MechFriesen/IG_Handle_hardware/README.md

# IG_Handle_hardware
Hardware parts list and assembly instructions
