MechFriesen/IG_Handle_hardware/Parts-list.xlsx

Sheet: Digikey
 | The HTSUS and ECCN information shown is for informational purposes only and is not a representation or warranty as to the accuracy or reliability of these classifications. All information is provided "as is" and is subject to change without notice. Any use made of the information provided is without recourse to Digi-Key and at the user's risk.
 | Index | Manufacturer Part Number | Manufacturer Name | Description | Requested Quantity 1 | Pack Quantity 1 | Pack Type 1 | Digi-Key Part Number 1 | Unit Price 1 | Extended Price 1 | Customer Reference | Requested Part Number | Datasheet | Part Status | Original Part numbers
USB Hub | 1 | 301-3010-71 | Digi | HUBPORT/7C USB 3.1 SUPERSPEED | 1 | 1 | Box | 602-2257-ND | 367.50000 | $367.50 | USB Hub | 602-2257-ND | https://www.digi.com/resources/library/data-sheets/prd_usb_hubport | Active | 602-2257-ND
Camera GPIO connectors | 2 | 1-1318120-3 | TE Connectivity AMP Connectors | CONN RECEPT 2.5 3POS KEY-X | 10 | 10 | Bulk | A29805-ND | 0.95000 | $9.50 |  | A29805-ND | https://www.te.com/commerce/DocumentDelivery/DDEController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 | Active | A29805-ND
 | 3 | 1-1318117-3 | TE Connectivity AMP Connectors | CONN HOUSING TAB 3POS KEY-X | 10 | 10 | Bulk | A29795-ND | 1.08000 | $10.80 |  | A29795-ND | https://www.te.com/commerce/DocumentDelivery/DDEController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 | Active | A29795-ND
 | 4 | 1318108-1 | TE Connectivity AMP Connectors | CONN SOCKET 24-28AWG CRIMP GOLD | 50 | 50 | Bulk | A29319-ND | 0.23000 | $11.50 |  | A29319-ND |  | Active | A29319-ND
 | 5 | 1318110-1 | TE Connectivity AMP Connectors | CONN TAB 24-28AWG CRIMP GOLD | 50 | 50 | Cut Tape (CT) | A29323CT-ND | 0.20000 | $10.00 |  | A29323CT-ND |  | Active | A29323CT-ND
Cable port sealing | 6 | 28558.4 | Conta-Clip, Inc. | KDS SEALING SLEEVE MULTI 4MM | 1 | 1 | Bag | 2080-28558.4-ND | 6.30000 | $6.30 | Trigger line grommet (4 holes) | 2080-28558.4-ND | https://catalog.conta-clip.com/en/DataSheet/index/ordernumber/28558.4 | Active | 2080-28558.4-ND
 | 7 | 28672.4 | Conta-Clip, Inc. | KDS SEALING SLEEVE MULTI 5MM | 2 | 2 | Bag | 2080-28672.4-ND | 6.30000 | $12.60 | USB grommet (4 holes) | 2080-28672.4-ND | https://catalog.conta-clip.com/en/DataSheet/index/ordernumber/28672.4 | Active | 2080-28672.4-ND
 | 8 | 28664.3 | Conta-Clip, Inc. | KDS-FP-IVR OG | 4 | 4 | Bag | 2080-28664.3-ND | 3.42000 | $13.68 | grommet locks | 2080-28664.3-ND | https://catalog.conta-clip.com/en/DataSheet/index/ordernumber/28664.3 | Active | 2080-28664.3-ND
 | 9 | 28520.4 | Conta-Clip, Inc. | KDS SMALL SEALING SLEEVE BLIND | 2 | 2 | Bag | 2080-28520.4-ND | 2.91000 | $5.82 |  | 2080-28520.4-ND | https://catalog.conta-clip.com/en/DataSheet/index/ordernumber/28520.4 | Active | 2080-28520.4-ND
 | 10 | 28555.4 | Conta-Clip, Inc. | KDS SEALING SLEEVE MULTI 5MM | 2 | 2 | Bag | 2080-28555.4-ND | 4.04000 | $8.08 | 2 hole | 2080-28555.4-ND | https://conta-clip.shop/en/DataSheet/index/ordernumber/28555.4 | Active | 2080-28555.4-ND
 | 11 | 28604.4 | Conta-Clip, Inc. | KDS SIZE 16 KIT | 1 | 1 | Box | 2080-28604.4-ND | 42.17000 | $42.17 |  | 2080-28604.4-ND | https://catalog.conta-clip.com/en/DataSheet/index/ordernumber/28604.4 | Active | 2080-28604.4-ND
Enclosure | 12 | PTQ-11055 | Bud Industries | BOX PLAS GRAY 8.270"L X 8.270"W | 1 | 1 | Box | 377-PTQ-11055-ND | 47.65000 | $47.65 | enclosure | 377-PTQ-11055-ND | https://www.budind.com/wp-content/uploads/2020/10/hbptq11055.pdf | Active | 377-PTQ-11055-ND
Quick splice connectors | 13 | 221-412/VE00-2500 | WAGO Corporation | COMPACT SPLICING CONNECTORFOR AL | 25 | 25 | Bulk | 2946-221-412/VE00-2500-ND | 0.57000 | $14.25 | lever splice 2 | 2946-221-412/VE00-2500-ND | //media.digikey.com/pdf/Data%20Sheets/WAGO%20PDFs/Electrical-Installation-60399507_Brochure_Sept_2019.pdf | Active | 2946-221-412/VE00-2500-ND
 | 14 | 221-413/VE00-2500 | WAGO Corporation | COMPACT SPLICING CONNECTORFOR AL | 10 | 10 | Bulk | 2946-221-413/VE00-2500-ND | 0.78000 | $7.80 |  | 2946-221-413/VE00-2500-ND |  | Active | 2946-221-413/VE00-2500-ND
 | 15 | 221-415/VE00-1000 | WAGO Corporation | COMPACT SPLICING CONNECTORFOR AL | 10 | 10 | Bulk | 2946-221-415/VE00-1000-ND | 1.10000 | $11.00 |  | 2946-221-415/VE00-1000-ND |  | Active | 2946-221-415/VE00-1000-ND
Teensy and mounting board | 16 | PPPC241LFBN-RC | Sullins Connector Solutions | CONN HDR 24POS 0.1 GOLD PCB | 2 | 2 | Tray | S7057-ND | 1.79000 | $3.58 | Teenys header | S7057-ND | //media.digikey.com/pdf/Data%20Sheets/Sullins%20PDFs/Female_Headers.100_DS.pdf | Active | S7057-ND
 | 17 | 1-1546215-2 | TE Connectivity AMP Connectors | TERM BLK 12P SIDE ENT 2.54MM PCB | 1 | 1 | Box | A134677-ND | 13.24000 | $13.24 | screw terminals | A134677-ND | https://www.te.com/commerce/DocumentDelivery/DDEController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 | Active | A134677-ND
 | 18 | SBB400 | Chip Quik Inc. | BREADBOARD GENERAL PURPOSE PTH | 1 | 1 | Bulk | SBB400-ND | 5.32000 | $5.32 | Teensy mount board | SBB400-ND | http://www.chipquik.com/datasheets/SBB400.pdf | Active | SBB400-ND
 | 19 | DEV-14058 | SparkFun Electronics | TEENSY 3.6 W/ HDRS K66 EVAL BRD | 1 | 1 | Bulk | 1568-1465-ND | 51.22 | 51.22 | Teensy |  | https://media.digikey.com/pdf/Data%20Sheets/Sparkfun%20PDFs/DEV-14058_Web.pdf

Sheet: 8020
Quantity | Unit of Measure | Product | Description
8+ | Each | 13084 | Roll in T-nut with spring
8+ | Each |  | M5 button head socket cap screw
4 | Each | 20-4113 | T-Slotted Framing Silver Surface Bracket for 20 mm High Rail, 1.5" Long
1 | Each | 20-4040 | 20-4040 Aluminum extrusion, 300mm
4 | Each | 94868A765 | Female Threaded Hex Standoff 18-8 Stainless Steel, 10mm Hex, 40mm Long, M5 x 0.8mm Thread
8 | Each |  | Socket Head Cap Screw, M5 x 0.8mm

Sheet: Sensors
PC |  | Intel NUC 8 (NUC8i5BEH) | Could use a more recent gen. Needs to be able to use 12V power supply.
LiDAR |  | Velodyne VLP-32 | Cable modified to have ethernet connection for data and PPS and GPRMC input for timing
Camera |  | FLIR BFS-U3-122S6 | Also have used BFS-U3-31S4
 | GPIO Cable
 | USB3 Cable |  | Power and data
IMU |  | MTi-30
 | USB Cable
