MechFriesen/IG_Handle_hardware/Solidworks_CAD/Top_level.SLDASM

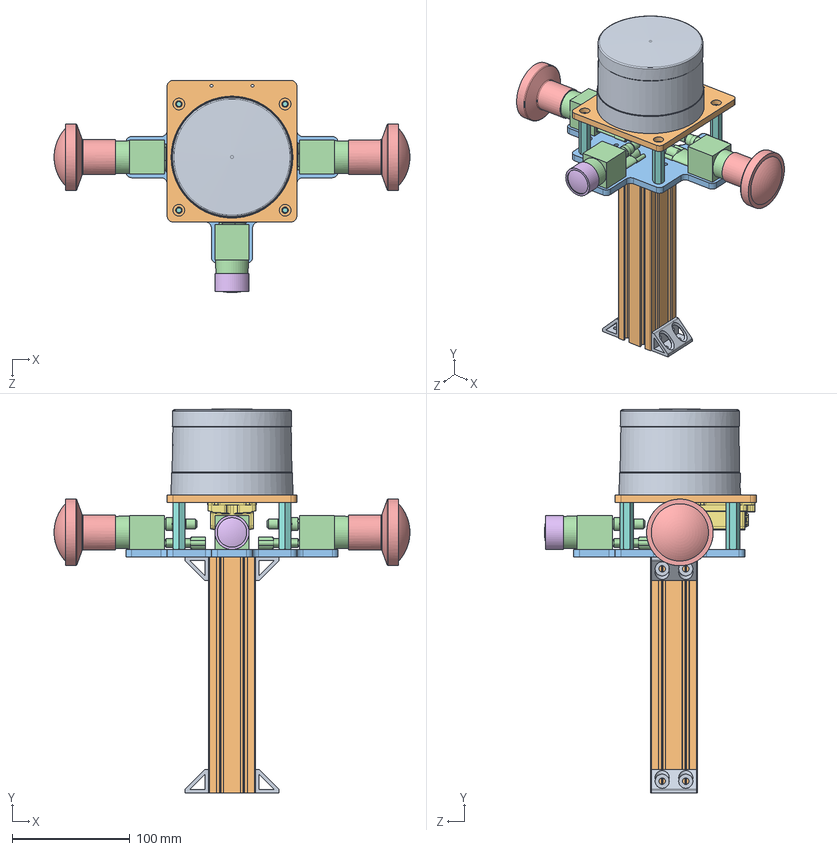
[picture p1: CAD file, 2022-04-28]
Solidworks_CAD/Top_level.SLDASM
301.6 x 325.4 x 179.8 mm
86-0101 REV B ENVELOPE, VLP-16
LiDAR_plate
camera_plate
BFS-U3-31S4 x 3
fisheye_lens x 2
plain_lens
140812_MTI_10_encased
M5x50_THRDED_HEX_STANDOFF x 4
bracket x 4
AlExt_4040
