MechFriesen/IG_Handle_hardware/Solidworks_CAD/blackfly_fisheye.SLDASM

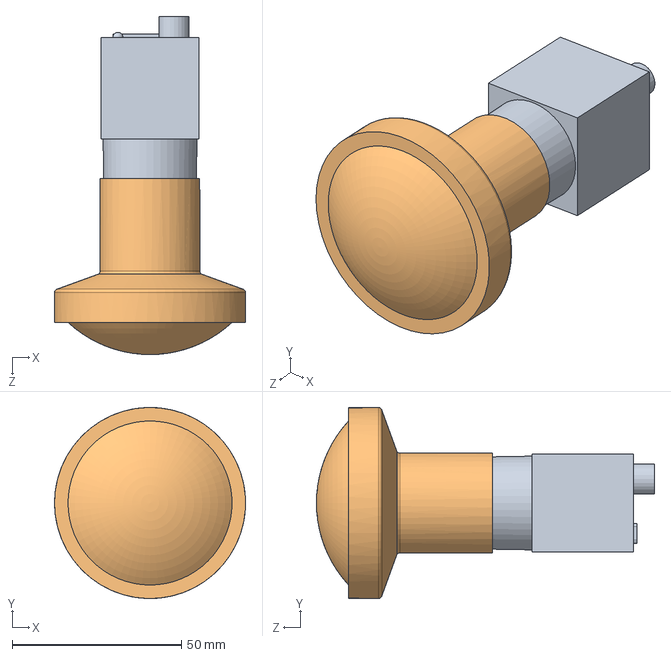
[picture p2: CAD file, 2022-04-28]
Solidworks_CAD/blackfly_fisheye.SLDASM
56.5 x 56.5 x 100.0 mm
BFS-U3-31S4
fisheye_lens
