MechFriesen/IG_Handle_hardware/Solidworks_CAD/blackfly_plain.SLDASM

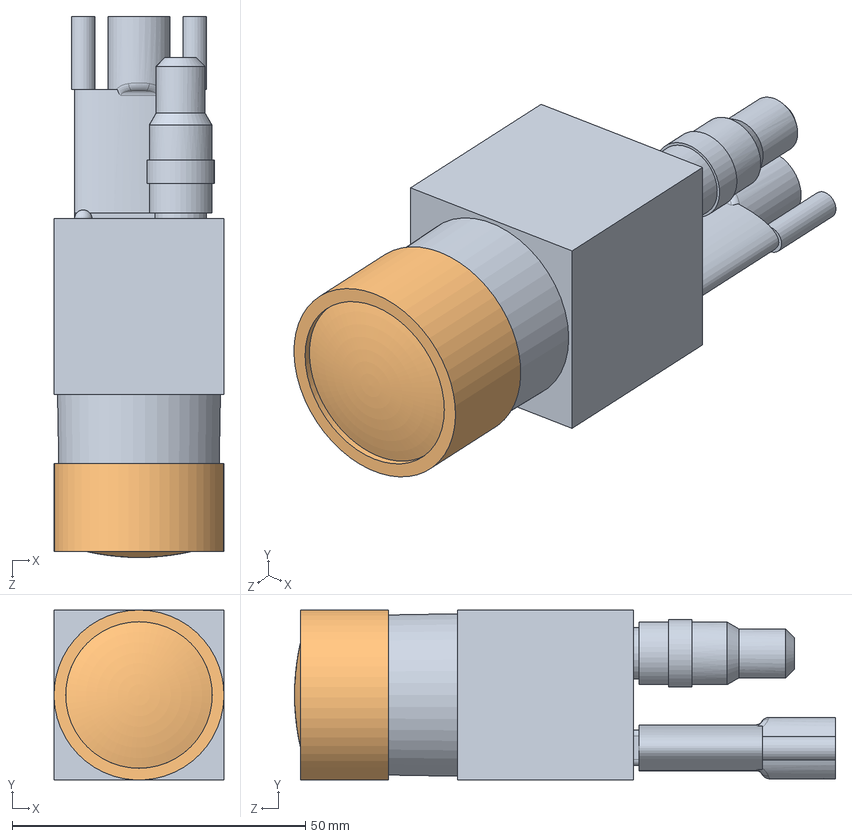
[picture p3: CAD file, 2022-04-28]
Solidworks_CAD/blackfly_plain.SLDASM
29.0 x 29.0 x 92.3 mm
BFS-U3-31S4
plain_lens
