MechFriesen/IG_Handle_hardware/Solidworks_CAD/Cameras.SLDASM

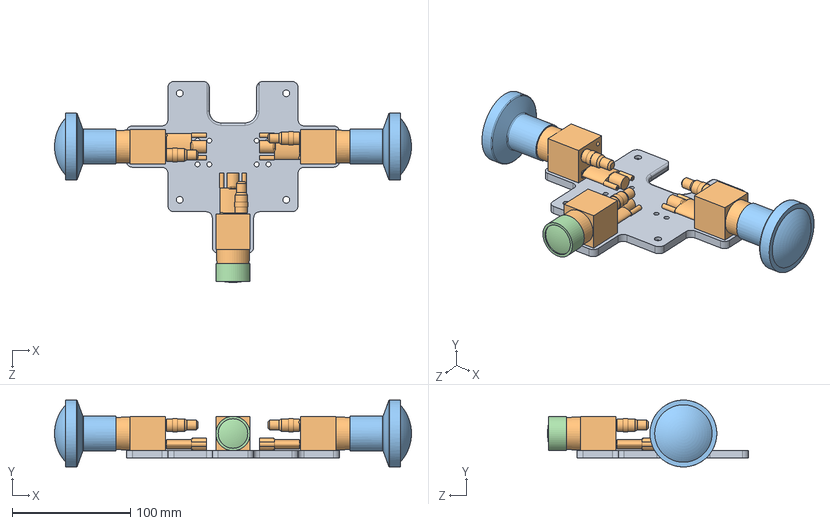
[picture p4: CAD file, 2022-04-28]
Solidworks_CAD/Cameras.SLDASM
301.6 x 56.5 x 169.8 mm
camera_plate
BFS-U3-31S4 x 3
fisheye_lens x 2
plain_lens
