MechFriesen/IG_Handle_hardware/Solidworks_CAD/bracket.SLDPRT

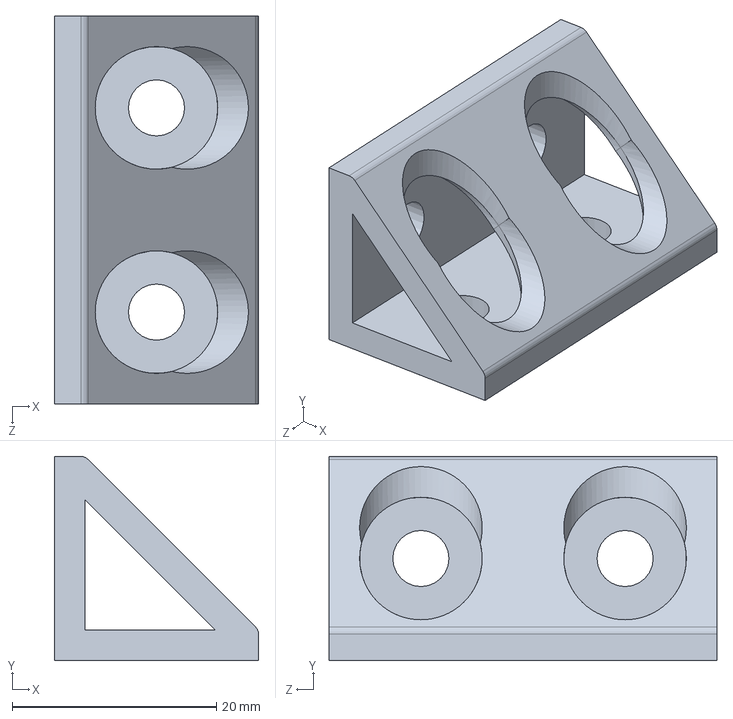
[picture p5: CAD file, 2022-04-28]
Solidworks_CAD/bracket.SLDPRT
20.0 x 20.0 x 38.0 mm
