MechFriesen/IG_Handle_hardware/Solidworks_CAD/fisheye_lens.SLDPRT

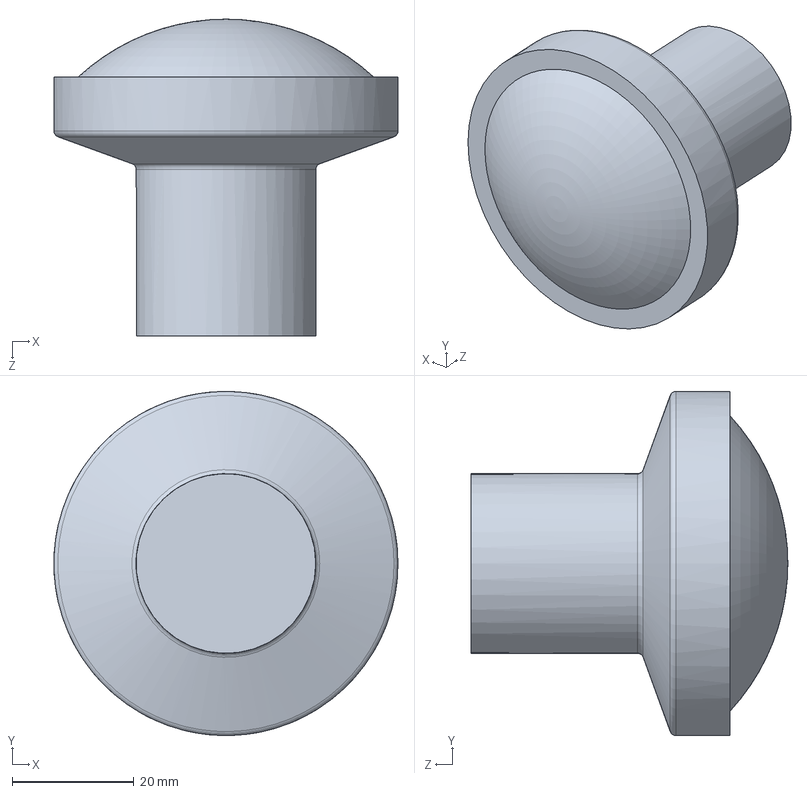
[picture p6: CAD file, 2022-04-28]
Solidworks_CAD/fisheye_lens.SLDPRT
56.5 x 56.5 x 52.0 mm
