MechFriesen/IG_Handle_hardware/Solidworks_CAD/camera_plate.SLDPRT

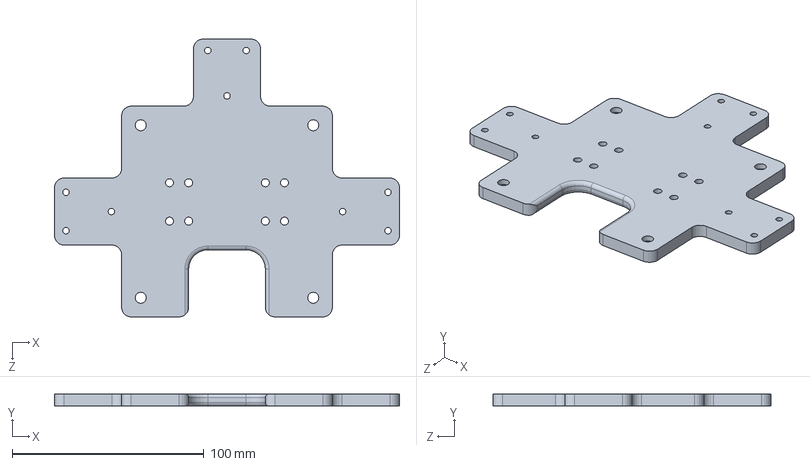
[picture p7: CAD file, 2022-04-28]
Solidworks_CAD/camera_plate.SLDPRT
180.0 x 6.35 x 145.0 mm
