MechFriesen/IG_Handle_hardware/Solidworks_CAD/LiDAR_plate.SLDPRT

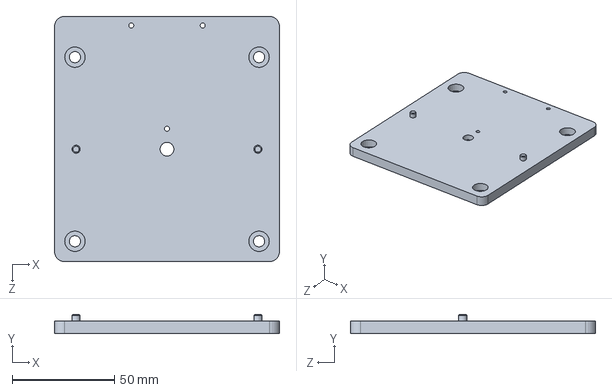
[picture p8: CAD file, 2022-04-28]
Solidworks_CAD/LiDAR_plate.SLDPRT
110.0 x 9.53 x 120.0 mm
