MechFriesen/IG_Handle_hardware/Solidworks_CAD/plain_lens.SLDPRT

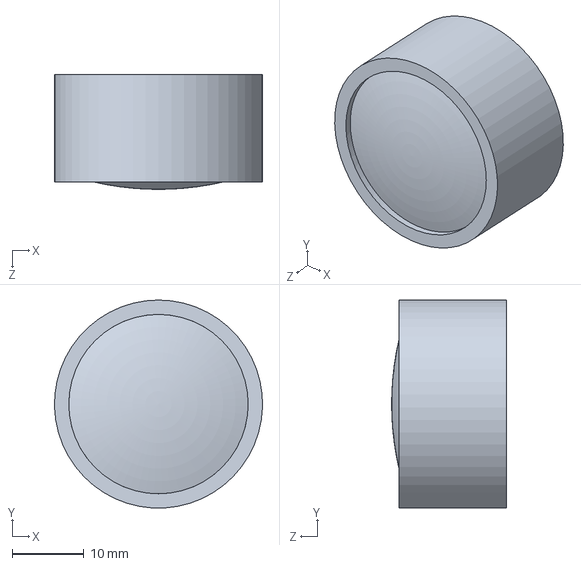
[picture p9: CAD file, 2022-04-28]
Solidworks_CAD/plain_lens.SLDPRT
29.0 x 29.0 x 16.0 mm
