MechFriesen/IG_Handle_hardware/Solidworks_CAD/AlExt_2040.SLDPRT

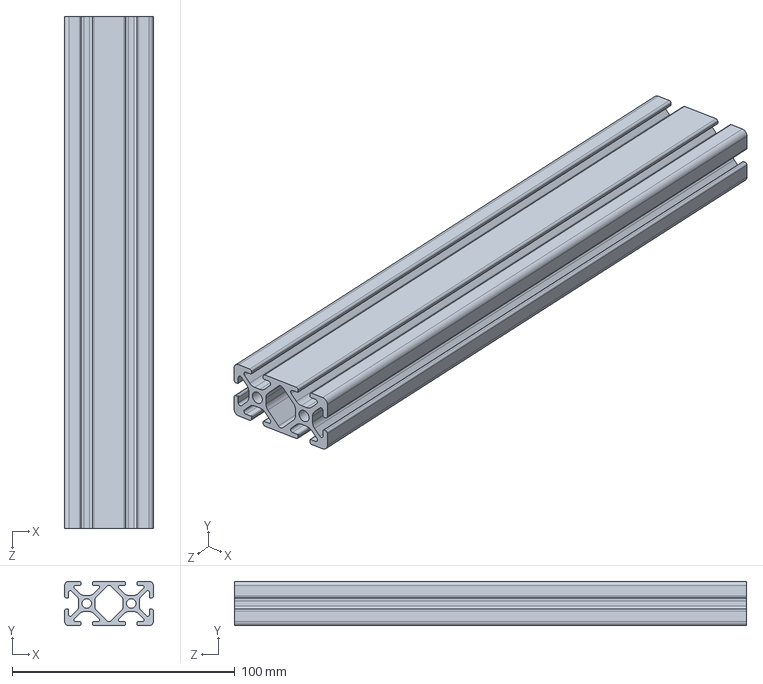
[picture p10: CAD file, 2022-04-28]
Solidworks_CAD/AlExt_2040.SLDPRT
40.0 x 20.0 x 230.0 mm
