MechFriesen/IG_Handle_hardware/Solidworks_CAD/86-0101 REV B ENVELOPE, VLP-16.SLDPRT

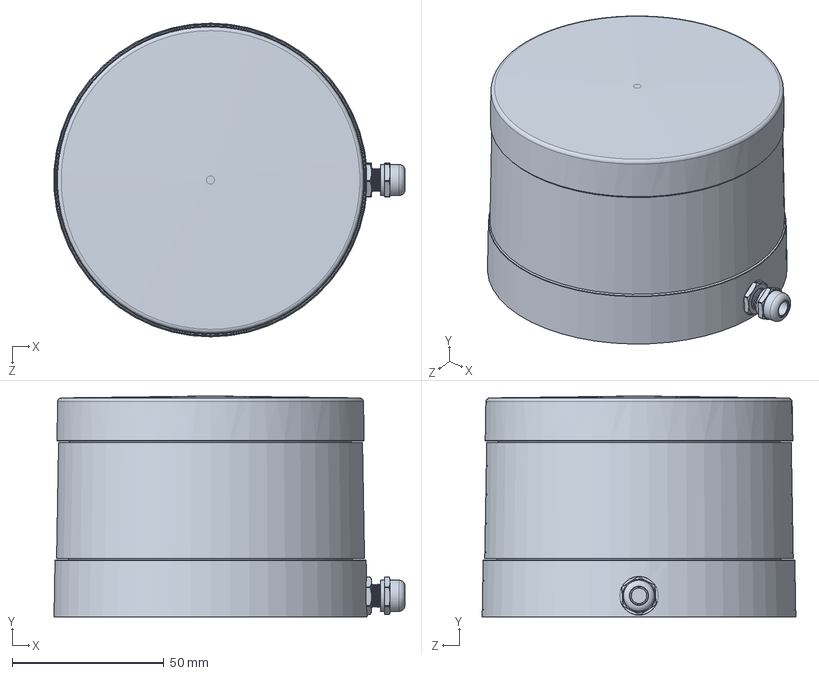
[picture p11: CAD file, 2022-04-28]
Solidworks_CAD/86-0101 REV B ENVELOPE, VLP-16.SLDPRT
115.5 x 72.7 x 103.3 mm
