MechFriesen/IG_Handle_hardware/Solidworks_CAD/BFS-U3-31S4.SLDPRT

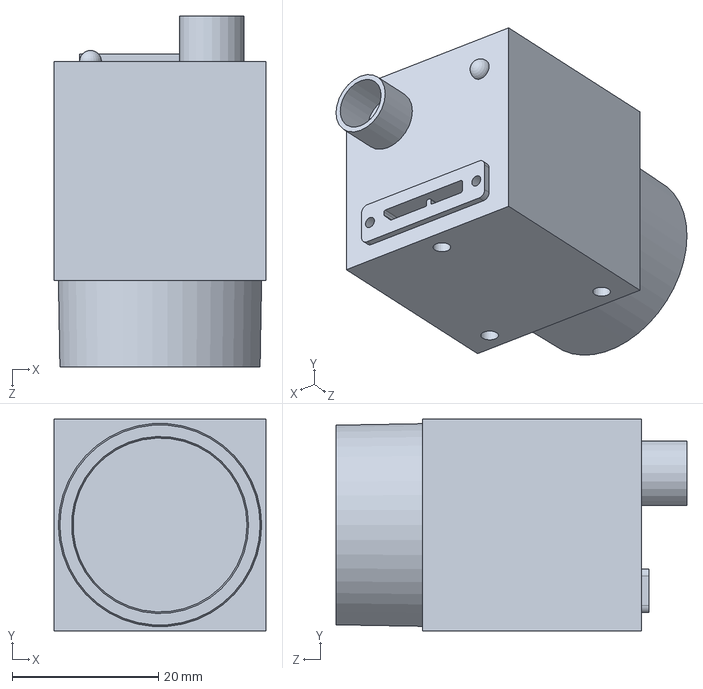
[picture p12: CAD file, 2022-04-28]
Solidworks_CAD/BFS-U3-31S4.SLDPRT
29.0 x 29.0 x 48.0 mm
