MechFriesen/IG_Handle_hardware/Solidworks_CAD/M5x50_THRDED_HEX_STANDOFF.SLDPRT

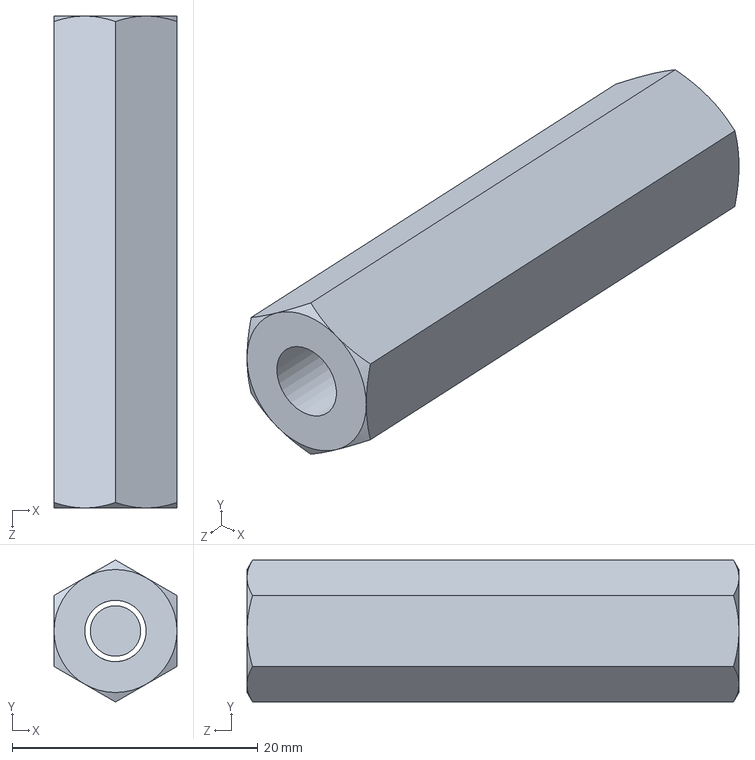
[picture p13: CAD file, 2022-04-28]
Solidworks_CAD/M5x50_THRDED_HEX_STANDOFF.SLDPRT
10.0 x 11.5 x 40.0 mm
