MechFriesen/IG_Handle_hardware/Solidworks_CAD/140812_MTI_10_encased.SLDPRT

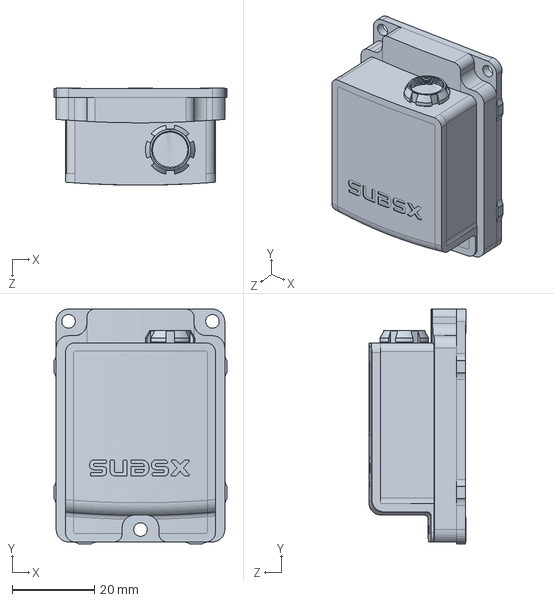
[picture p14: CAD file, 2022-04-28]
Solidworks_CAD/140812_MTI_10_encased.SLDPRT
41.9 x 57.0 x 23.6 mm
