MechFriesen/IG_Handle_hardware/(list of files, cad)

Other CAD files:
Solidworks_CAD/AlExt_4040.sldprt
Solidworks_CAD/LiDAR_plate.SLDDRW
Solidworks_CAD/camera_plate.SLDDRW
Solidworks_CAD/camera_plate_option2.SLDDRW
