MechFriesen/IG_Handle_hardware/(commit log)

2022-04-28 Added CAD files
    [140812_MTI_10_encased.SLDPRT, 86-0101 REV B ENVELOPE, VLP-16.SLDPRT, AlExt_2040.SLDPRT, AlExt_4040.sldprt, BFS-U3-31S4.SLDPRT, Cameras.SLDASM, LiDAR_plate.SLDDRW, LiDAR_plate.SLDPRT]
2022-05-09 Added part list
    [Parts-list.xlsx]
2022-05-20 Updated Sensors sheet of Parts-list.xlsx
    [Parts-list.xlsx]
